tarosay/DangoSat2/README.md

# DangoSat2
DangoSat Project Rev.2
だんごサットプロジェクト Rev.2 の資料集です。
