tarosay/DangoSat2/RelatedDocuments/DangoSat説明資料.pdf

# グライダー型缶サット 「だんごサット」

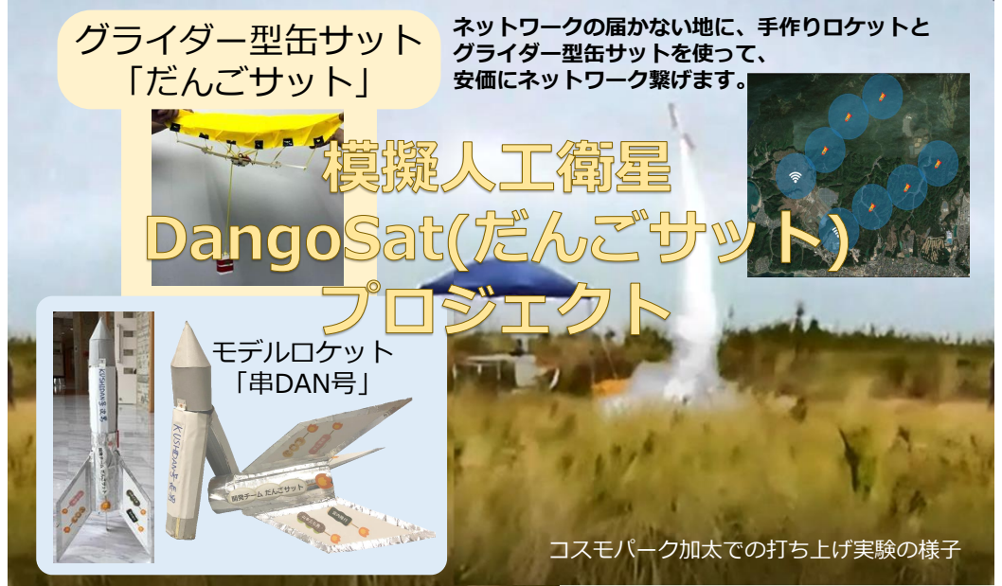
[picture p1: page 1]
モデルロケット 「串DAN号」; ネットワークの届かない地に、手作りロケットと グライダー型缶サットを使って、 安価にネットワーク繋げます。; コスモパーク加太での打ち上げ実験の様子

# だんごサットと串だん号の説明

## ・手作りモデルケットの設計: 全長1m以下、Φ70×20mmペイロード積載可能 ・滑空可能な缶サットの設計: 自立グライダー型、数km無線通信可能

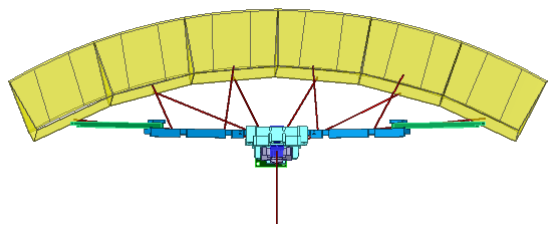
[picture p2: figure]
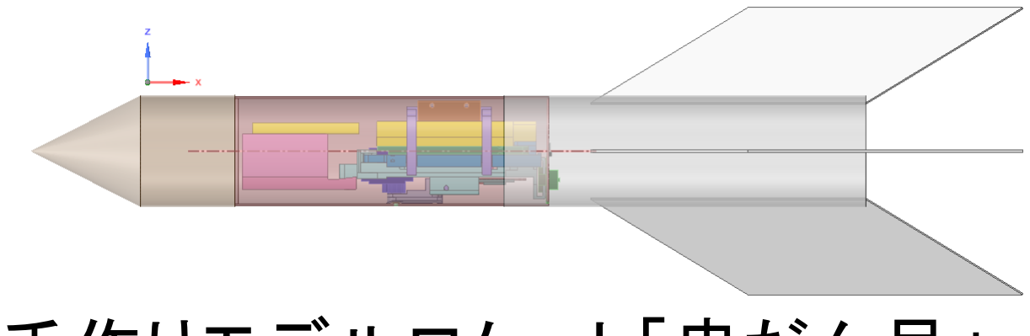
[picture p3: figure]

## 手作りモデルロケット「串だん号」 グライダー型缶サット「だんごサット」

# モデルロケット串だん号

## ●モデルロケットＧ型エンジンまで搭載可能

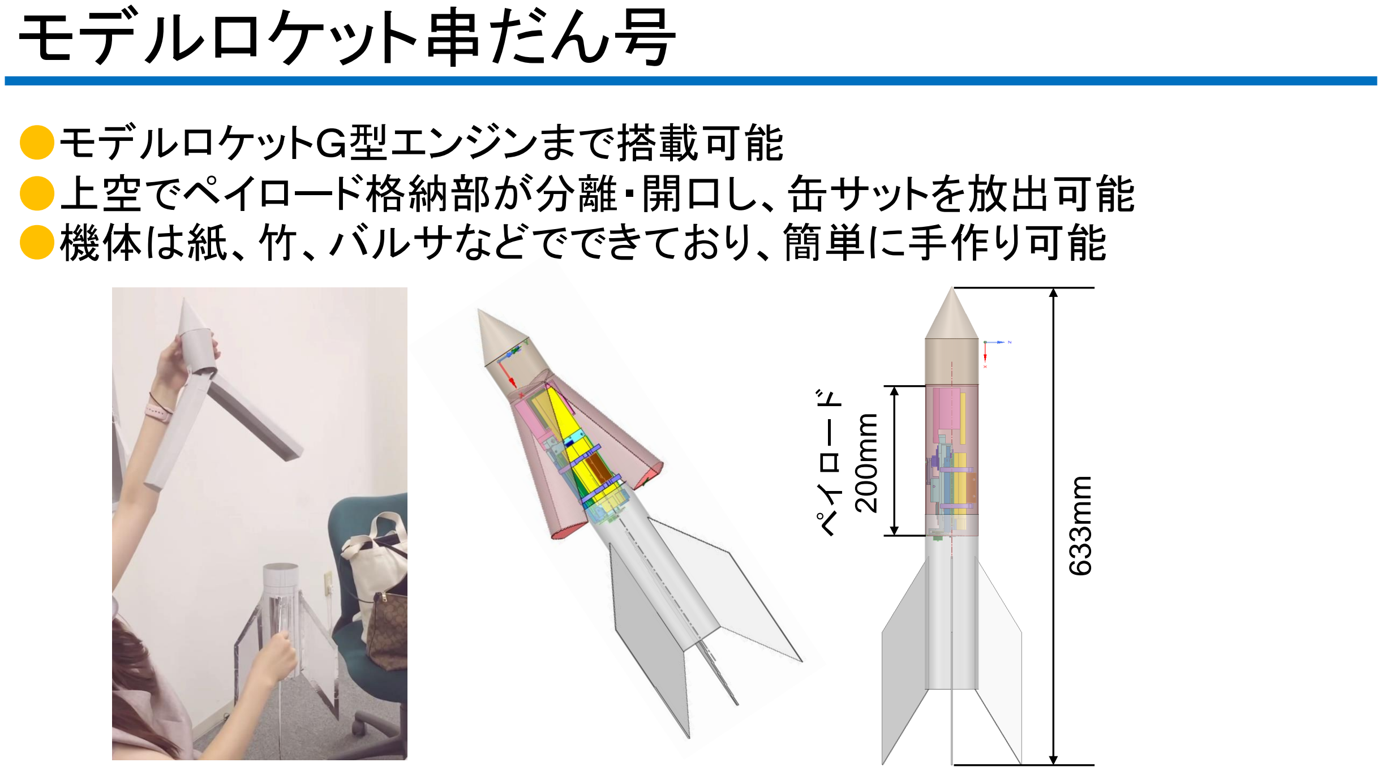
[picture p4: page 3]

633mm

ペイロード
200mm

## ●上空でペイロード格納部が分離・開口し、缶サットを放出可能 ●機体は紙、竹、バルサなどでできており、簡単に手作り可能

# モデルロケット串だん号

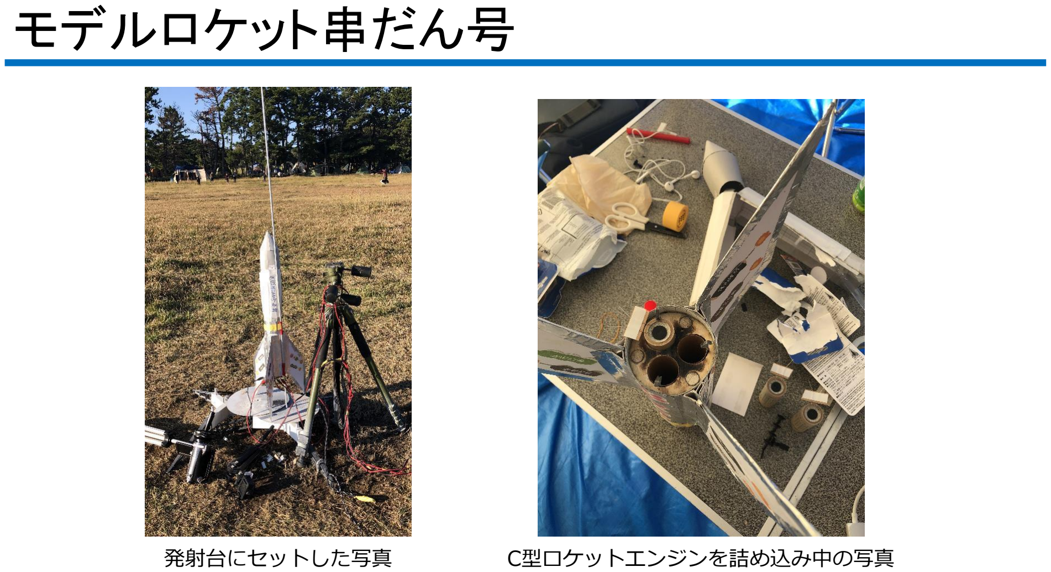
[picture p5: page 4]

発射台にセットした写真 | C型ロケットエンジンを詰め込み中の写真

# だんごサット

## - グライダーパラシュートによる目的地への滑空可能 - LoRa通信機能によるマルチホップ通信可能 - 遠隔操作によるRubyプログラムの書き換え可能 - 各種センサを搭載可能 - モデルロケットも含めて低コストで簡単に製作可能

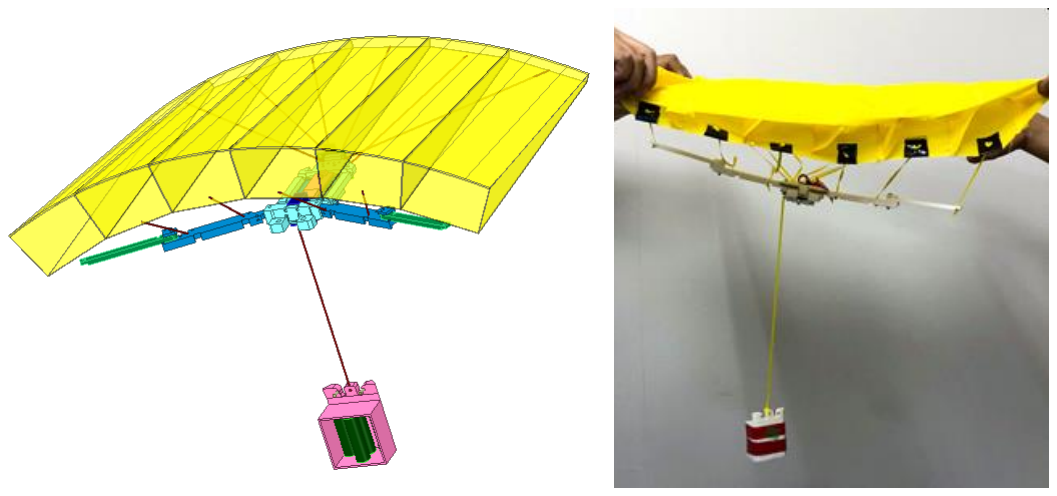
[picture p6: figure]

・前方から風を受けるとパラシュートがグライダー型に
膨らむ。
・重りの左右移動により旋回。

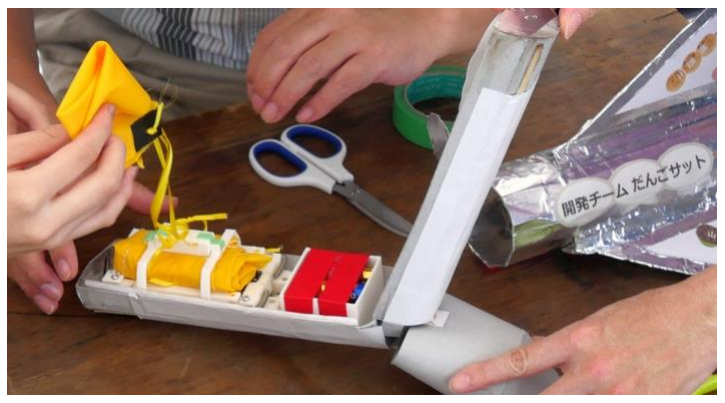
[picture p7: figure]

・Φ68mm×200mmのサイズに折りた
ためる。
・空中でグライダー型に展開する。

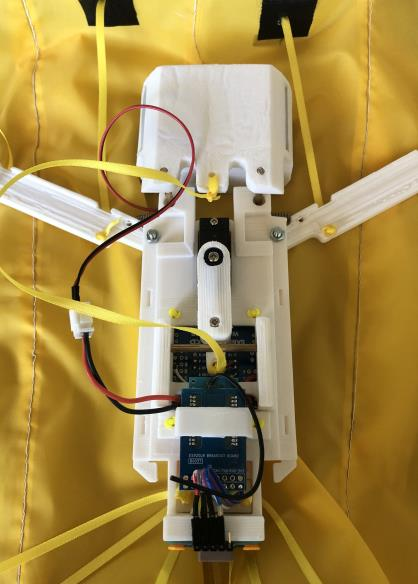
[picture p8: figure]

・LoRa無線機を搭載し、ホップ
通信、TTN-GW送信は確認済。
(ホップによるkmオーダー通信
は実現できていない)

# だんごサットの展開の仕組み

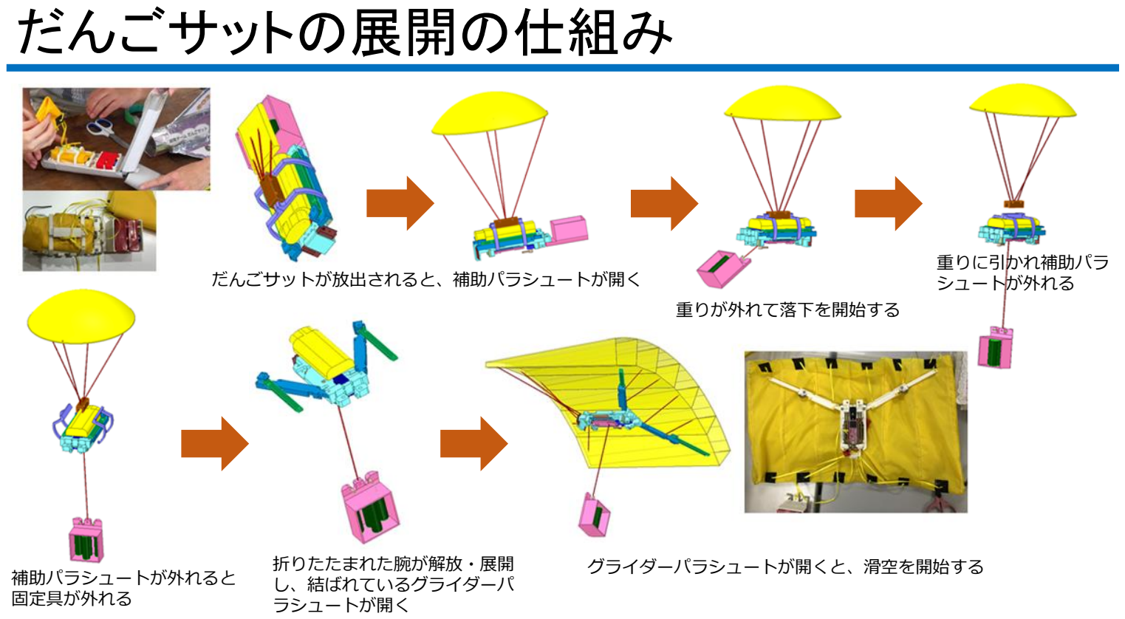
[picture p9: page 6]

補助パラシュートが外れると
固定具が外れる

だんごサットが放出されると、補助パラシュートが開く
重りが外れて落下を開始する

重りに引かれ補助パラ
シュートが外れる
折りたたまれた腕が解放・展開 | グライダーパラシュートが開くと、滑空を開始する
し、結ばれているグライダーパ
ラシュートが開く

# だんごサットの部品構成

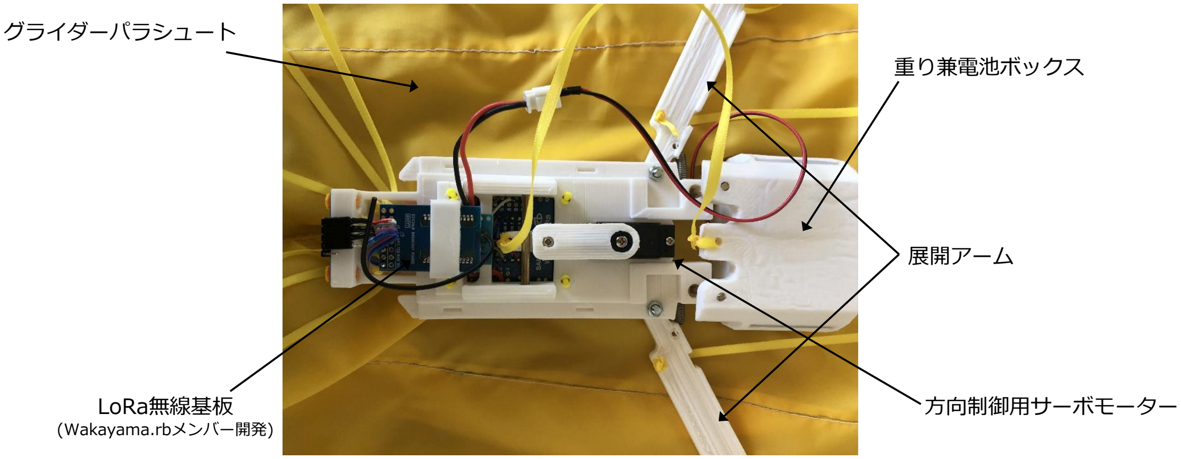
[picture p10: figure]
LoRa無線基板; 方向制御用サーボモーター; (Wakayama.rbメンバー開発); グライダーパラシュート

展開アーム

裏側から見た写真

重り兼電池ボックス

# だんごサットの部品構成

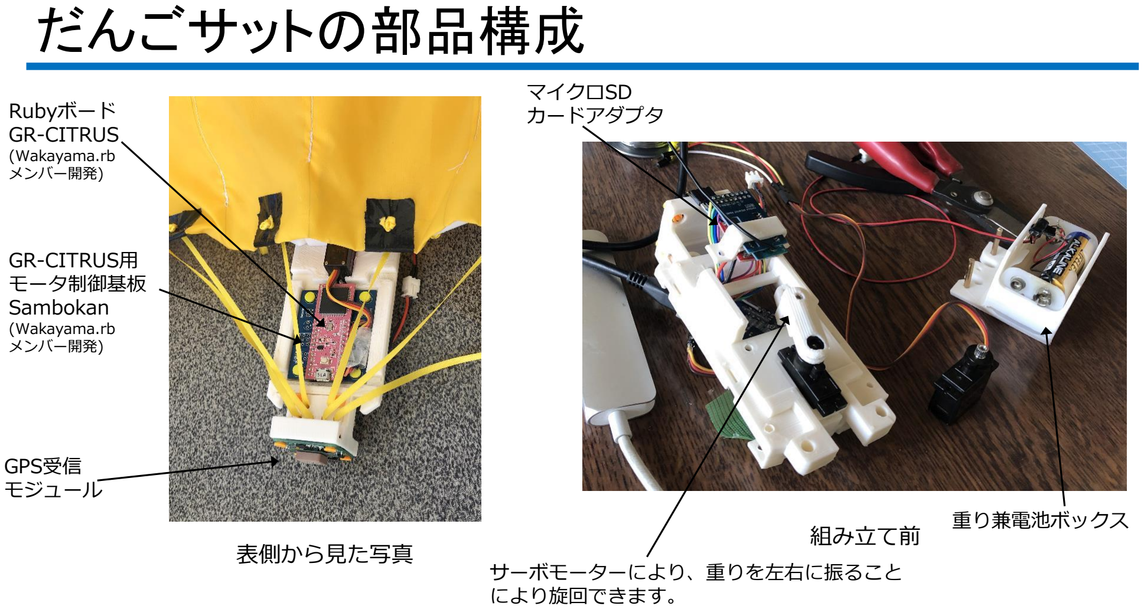
[picture p11: page 8]

組み立て前

マイクロSD
カードアダプタ

表側から見た写真

重り兼電池ボックス

Rubyボード
GR-CITRUS
(Wakayama.rb
メンバー開発)

GPS受信
モジュール

GR-CITRUS用
モータ制御基板
Sambokan
(Wakayama.rb
メンバー開発)

サーボモーターにより、重りを左右に振ること
により旋回できます。

# だんごサットの滑空時のイメージ

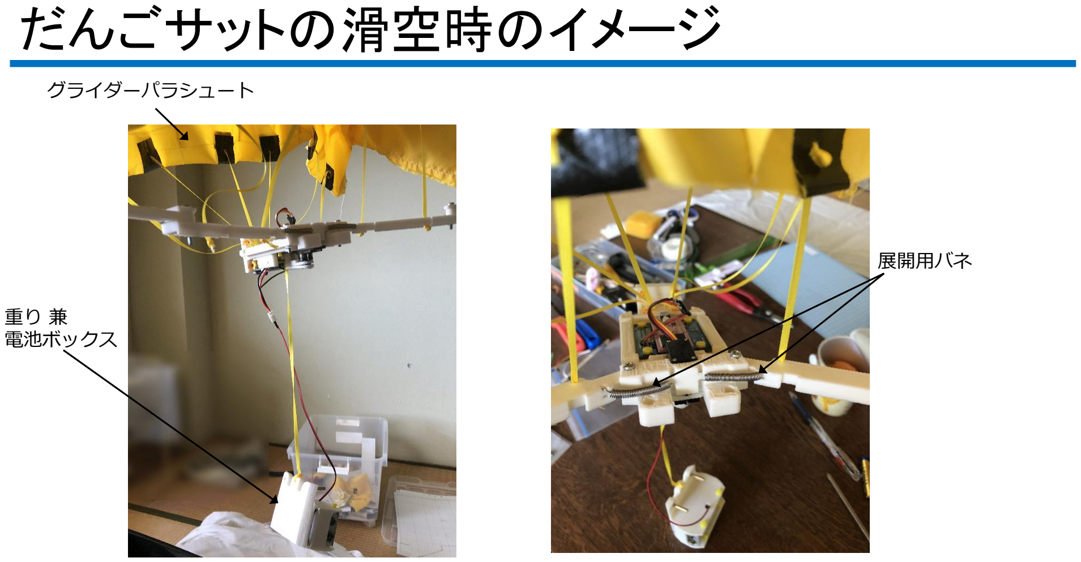
[picture p12: page 9]

展開用バネ

グライダーパラシュート

重り 兼
電池ボックス

# だんごサットの落下後

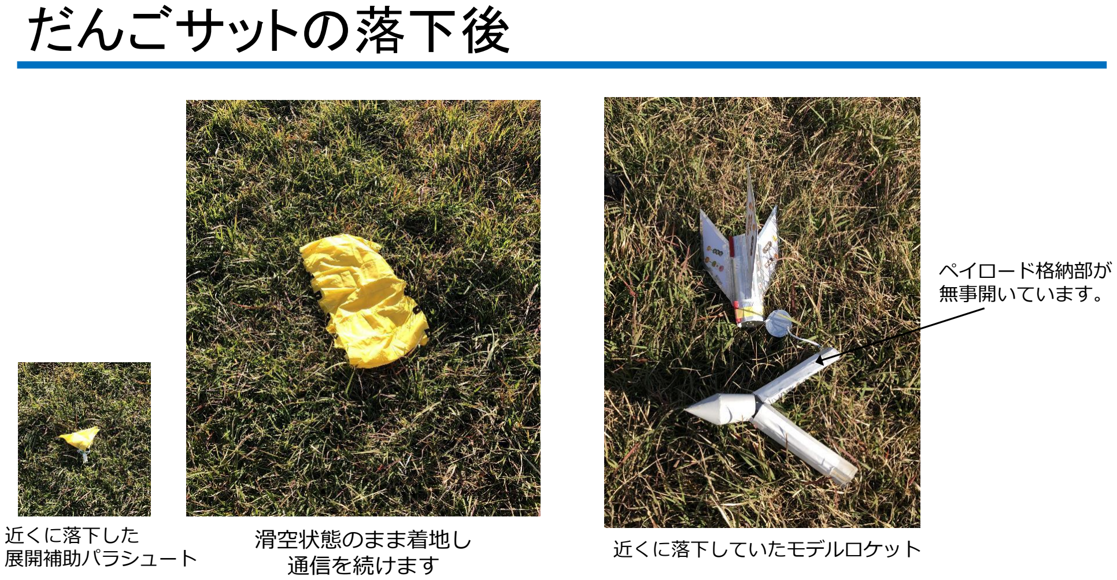
[picture p13: page 10]

ペイロード格納部が
無事開いています。

近くに落下していたモデルロケット 近くに落下した
展開補助パラシュート

滑空状態のまま着地し
通信を続けます

# だんごサットのシステム構成

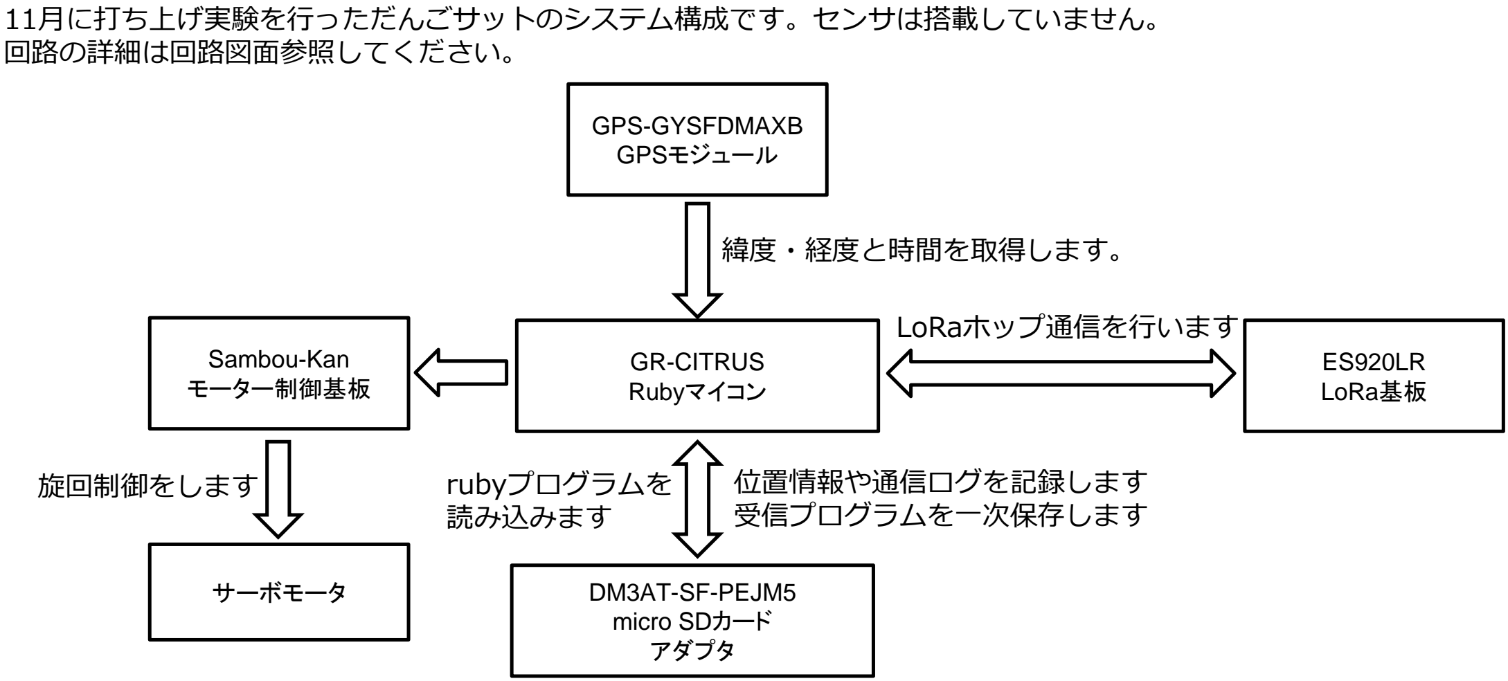
[picture p14: figure]
GPS-GYSFDMAXB GPSモジュール; GR-CITRUS Rubyマイコン; DM3AT-SF-PEJM5 micro SDカード アダプタ; ES920LR LoRa基板; サーボモータ; 11月に打ち上げ実験を行っただんごサットのシステム構成です。センサは搭載していません。 回路の詳細は回路図面参照してください。; 緯度・経度と時間を取得します。; Sambou-Kan モーター制御基板; 位置情報や通信ログを記録します 受信プログラムを一次保存します; rubyプログラムを 読み込みます; LoRaホップ通信を行います; 旋回制御をします

# だんごサットのプログラム書き換えの仕組み

40バイト程度ずつプログラムを
送信する

LoRaのホップ通信は、50バイト以下のペイロードしか扱えません。

通信PC | DangoSat-1

DangoSat-2

DangoSat-3

基本的にはブロードキャスト送信を行う

・DangoSat-3に
プログラムを送信したい

どこかを経由して
DangoSat-3にたどり着く

中継に徹している

中継に徹している

プログラムが書き
換わったら、その
旨を返信する

1.書き換えたいプログラムとDangoDat識別番号を付け て、ペイロードサイズ40バイト程度のプログラムを順
次送り出す。
2.書き換わったという返信が取得できるまで、プログラ ムを送信し続ける。

細かなプロトコルの詳細は、まだ設計できていません。

# プログラム紹介

1.DangoSat2 (DangoSatの飛行プログラム) 「GPSから緯度経度、日時の取得」「指定した緯度経度に向かった滑空」「書き換えコマンドを受信す ると書き換えモードに移行」「ログ保存」などのプログラムです。

2. BinaryRecv (プログラム受信プログラム) LoRa無線経由で送信されてくるデータを受信して、rubyプログラムを再構築し自分自身を書き換える プログラムです。
3. BinarySend (プログラム送信プログラム) LoRa無線経由でプログラムを細切れにしてブロードキャスト送信するプログラムです。これもRubyで 書いています。
4. mainCopyToSD
RubyプログラムをSDカードに一次的に保管するプログラムです。テスト用のコードです。
5. RecvCommand
プログラム書き換え移行するプログラムのテスト用のコードです。

# 今後の課題

## - グライダーパラシュートの大型化→方向制御がうまくできていないため。 - モデルロケットの大型化→DangoSatが大きくなるので。 - 電源の高出力化→システムを安定させるため。 - LoRaアンテナの大型化→通信距離を延ばすため。 - センサの搭載→温湿度などの環境測定を行いたい。 - プログラム書き換えプロトコルの改良→現在は書き換えフィードバックなど無いため

## まだまだ未完成です。 活動はWakayama.rb内などで続けていきたいと思います。

# その他の資料

# NASA Space Apps Challenge 2020

## ●NASA Space Apps Challengeのグローバルノミネートに選ばれました。

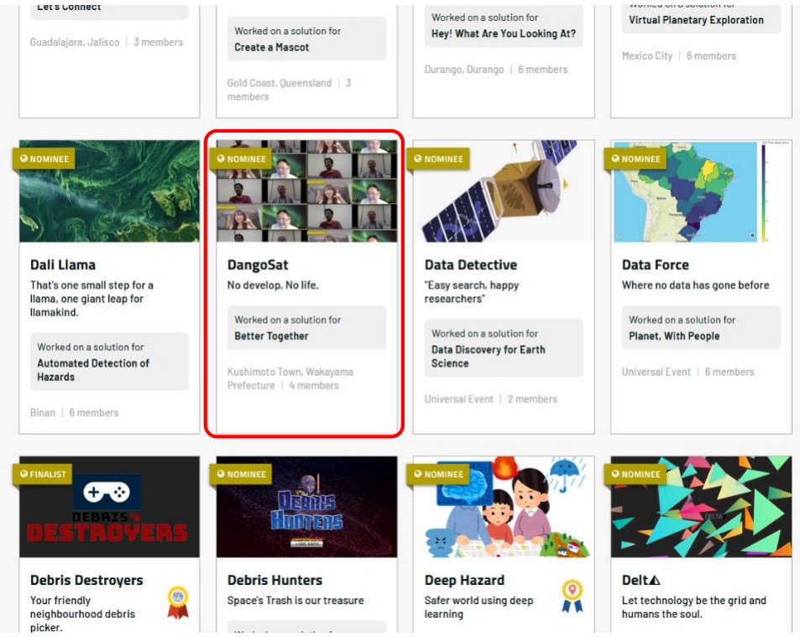
[picture p15: figure]

https://2020.spaceappschallenge.org/challenges/confront/better-together/teams/dangosat/project

# ロケットの手作り風景

## ●子供達でも製作可能

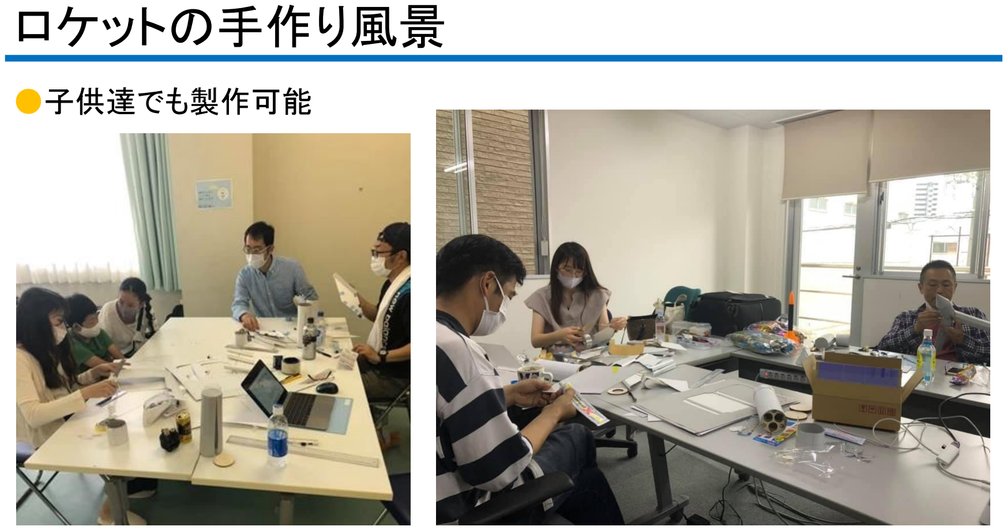
[picture p16: page 17]

# モデルロケットの打ち上げの様子

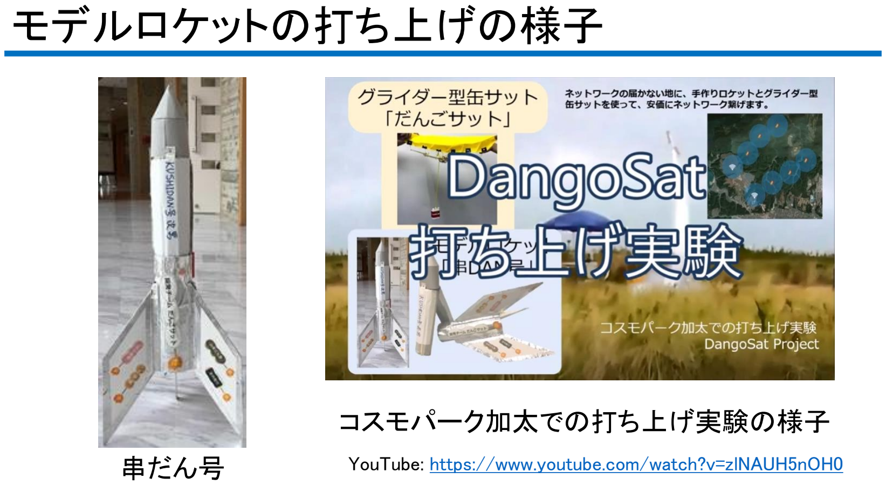
[picture p17: page 18]

## 串だん号

## コスモパーク加太での打ち上げ実験の様子

YouTube: https://www.youtube.com/watch?v=zlNAUH5nOH0
