tarosay/DangoSat2/ElectricCircuitSchematic/CanSat2020_1113_05 - Schematic.pdf

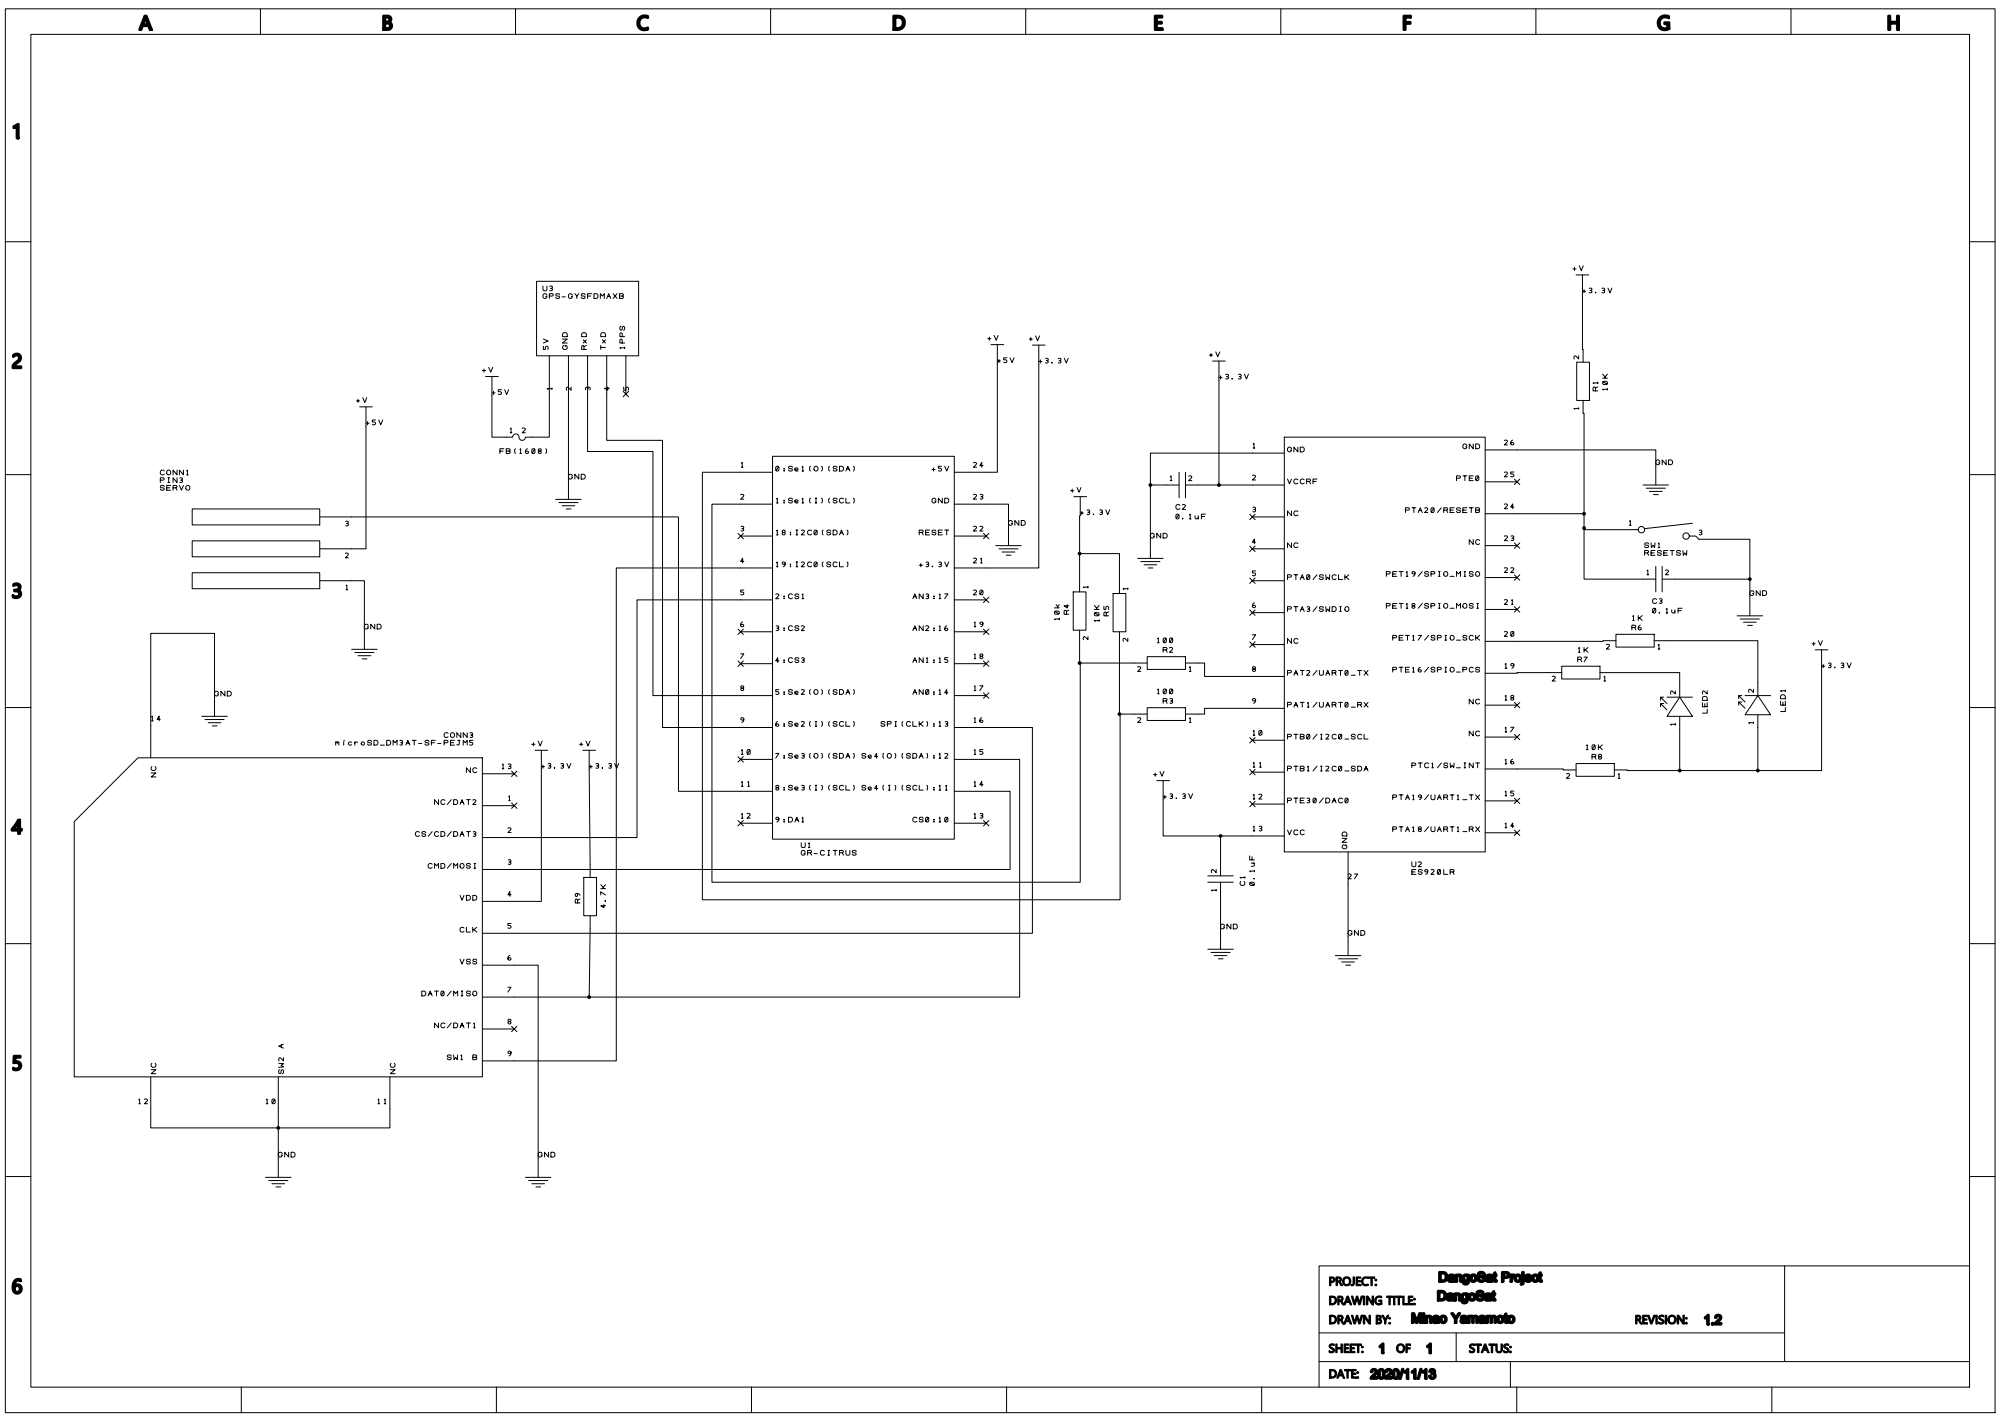
[picture p18: page 1]
