tarosay/DangoSat2/(commit log)

2020-12-04 最初のコミット
    [CanSat2020_1113_05.sch]
2020-12-04 説明資料のPDF追加
2020-12-04 資料の修正
2021-01-06 説明資料の修正
